DJorange-fo/WireLessCharge/hardwork/SCH_Schematic1_2026-05-12.pdf

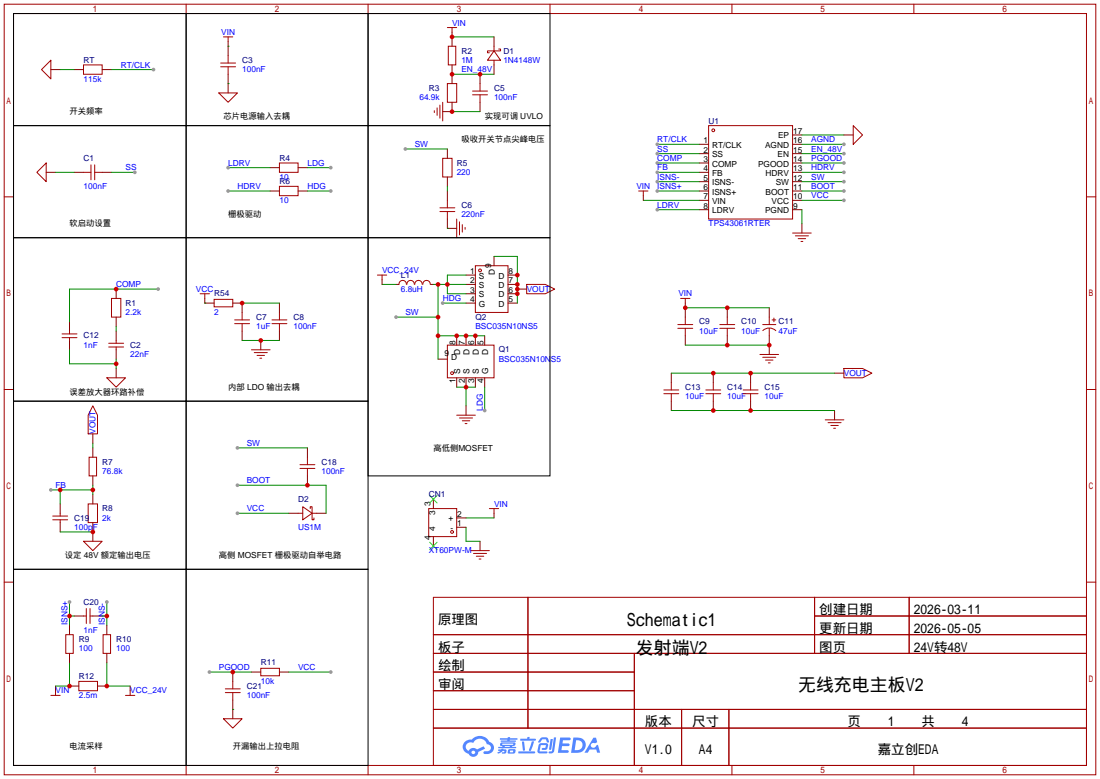
[picture p16: page 1]

VCC 10 BOOT 11 SW 12 HDRV 13 PGOOD 14 EN 15 AGND 16 EP 17

原理图 | Schematic1 | 创建日期 | 2026-03-11

更新日期 | 2026-05-05

板子 | 发射端V2 | 图页 | 24V转48V
绘制 | | 无线充电主板V2
审阅

V1.0 | A4 | 嘉立创EDA

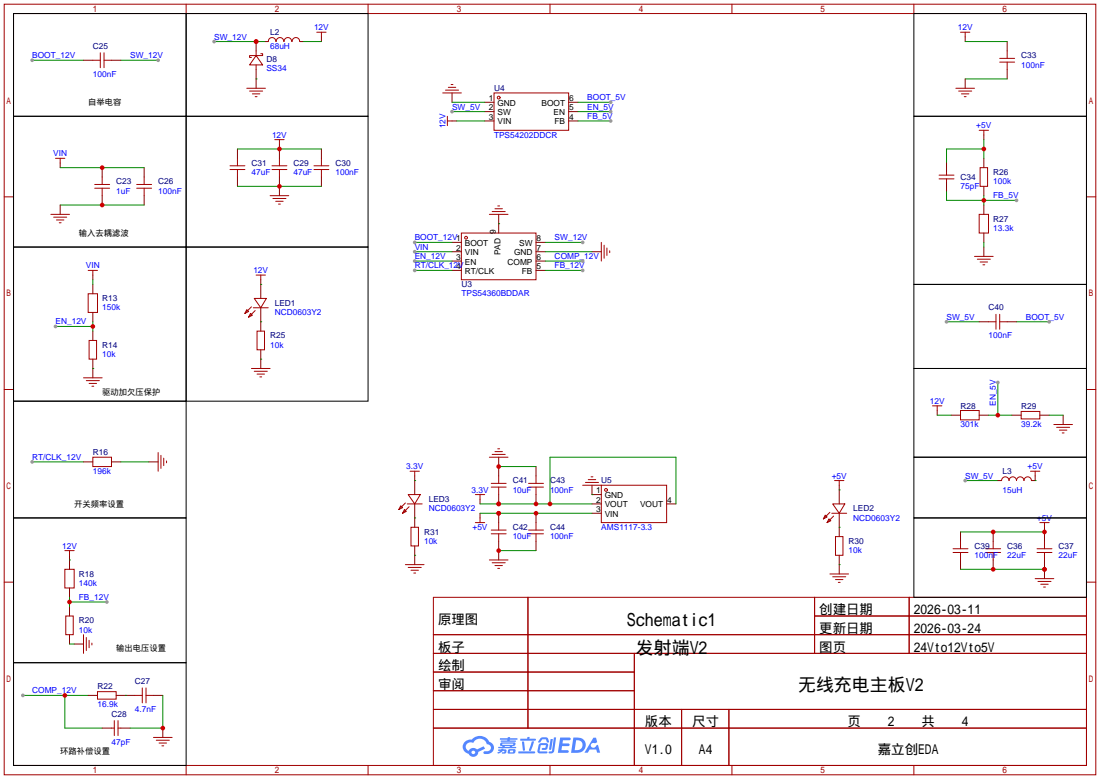
[picture p17: page 2]

原理图 | Schematic1 | 创建日期 | 2026-03-11

更新日期 | 2026-03-24

板子 | 发射端V2 | 图页 | 24Vto12Vto5V
绘制 | | 无线充电主板V2
审阅

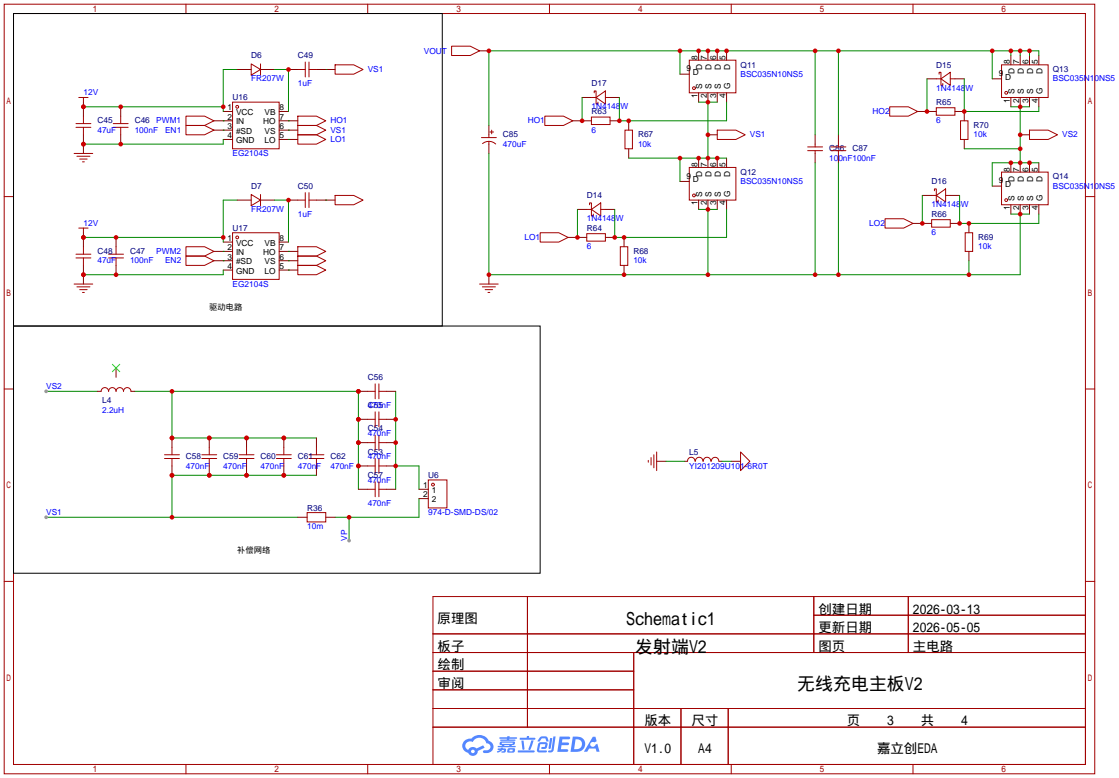
[picture p18: page 3]

原理图 | Schematic1 | 创建日期 | 2026-03-13

更新日期 | 2026-05-05

板子 | 发射端V2 | 图页 | 主电路
绘制 | | 无线充电主板V2
审阅

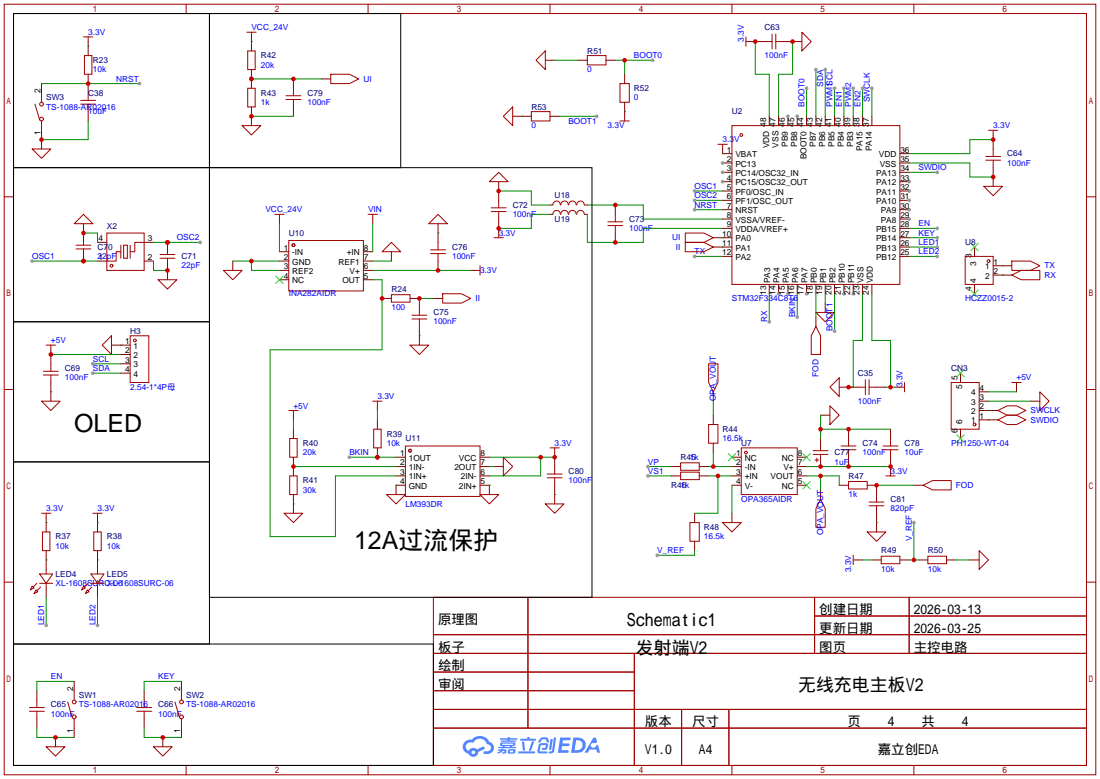
[picture p19: page 4]

原理图 | Schematic1 | 创建日期 | 2026-03-13

更新日期 | 2026-03-25

板子 | 发射端V2 | 图页 | 主控电路
绘制 | | 无线充电主板V2
审阅
