DJorange-fo/WireLessCharge/code/wpt_v2/Core/Src/main.c

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
/* Includes ------------------------------------------------------------------*/
#include "main.h"
#include "adc.h"
#include "dma.h"
#include "tim.h"
#include "gpio.h"

/* USER CODE BEGIN Includes */
#include "fz_hbridge.h"
#include "adc_sensor.h"

#ifdef USE_FREERTOS
#include "FreeRTOS.h"
#include "task.h"

/* External task functions (defined in app_tasks.c) */
extern void vTaskController(void *pvParameters);
extern void vTaskPeripheral(void *pvParameters);

/* System configuration helpers (defined in syscfg.c) */
extern void syscfg_jtag_release(void);
extern void syscfg_powerup_safety(void);
#endif

/* USER CODE END Includes */


void SystemClock_Config(void);
/**
  * @brief  The application entry point.
  * @retval int
  */
int main(void)
{

  /* MCU Configuration--------------------------------------------------------*/

  /* Reset of all peripherals, Initializes the Flash interface and the Systick. */
  HAL_Init();

  /* Configure the system clock */
  SystemClock_Config();

  /* USER CODE BEGIN SysInit */
    /* JTAG release + power-up safety.
     * syscfg_jtag_release() MUST run before MX_GPIO_Init(),
     * otherwise PB3/PB4/PA15 stay locked in JTAG mode. */
    syscfg_jtag_release();
    syscfg_powerup_safety();
  /* USER CODE END SysInit */

  /* Initialize all configured peripherals */
  MX_GPIO_Init();
  MX_DMA_Init();
  MX_TIM2_Init();
  MX_TIM3_Init();
  MX_ADC1_Init();
  /* USER CODE BEGIN 2 */
  fz_hbridge_init();
  fz_hbridge_set_phase(180);

  /* Start ADC1 + DMA circular scan (adc_raw[3] updated continuously) */
  adc_sensor_start();

  #ifdef USE_FREERTOS
  /* FreeRTOS kernel interrupts must be lowest priority on Cortex-M4. */
  HAL_NVIC_SetPriority(SysTick_IRQn,   configLIBRARY_LOWEST_INTERRUPT_PRIORITY, 0);
  HAL_NVIC_SetPriority(PendSV_IRQn,    configLIBRARY_LOWEST_INTERRUPT_PRIORITY, 0);

  {
      extern void vTaskController(void *pv);
      extern void vTaskPeripheral(void *pv);

      xTaskCreate(vTaskController, "ctrl", 200, NULL, 3, NULL);
      xTaskCreate(vTaskPeripheral, "peri", 200, NULL, 1, NULL);
  }

  vTaskStartScheduler();
  #endif
  /* USER CODE END 2 */

  /* Infinite loop */
  /* USER CODE BEGIN WHILE */
  while (1)
  {
    /* USER CODE END WHILE */

    /* USER CODE BEGIN 3 */
    /* Application logic runs in FreeRTOS tasks (app_tasks.c). */
  }
  /* USER CODE END 3 */
}

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
