DJorange-fo/WireLessCharge/code/wpt_v2/wpt_v2.ioc

Mcu.UserName=STM32F334C8Tx
PA0.GPIO_Label=VIN
PA0.Signal=ADC1_IN1
PA1.GPIO_Label=Idc
PA1.Signal=ADC1_IN2
PA13.Signal=SYS_JTMS-SWDIO
PA14.Signal=SYS_JTCK-SWCLK
PA15.GPIO_Label=EN2
PA15.Signal=GPIO_Output
PB0.GPIO_Label=Iac
PB0.Signal=ADC1_IN11
PB15.GPIO_Label=EN
PB15.Signal=GPIO_Input
PB3.GPIO_Label=PWM2
PB3.Signal=S_TIM2_CH2
PB4.GPIO_Label=EN1
PB4.Signal=GPIO_Output
PB5.GPIO_Label=PWM1
PB5.Signal=S_TIM3_CH2
