DJorange-fo/WireLessCharge/code/wpt_v2/Core/Inc/main.h

#define VIN_Pin GPIO_PIN_0
#define VIN_GPIO_Port GPIOA
#define Idc_Pin GPIO_PIN_1
#define Idc_GPIO_Port GPIOA
#define Iac_Pin GPIO_PIN_0
#define Iac_GPIO_Port GPIOB
#define EN_Pin GPIO_PIN_15
#define EN_GPIO_Port GPIOB
#define EN2_Pin GPIO_PIN_15
#define EN2_GPIO_Port GPIOA
#define PWM2_Pin GPIO_PIN_3
#define PWM2_GPIO_Port GPIOB
#define EN1_Pin GPIO_PIN_4
#define EN1_GPIO_Port GPIOB
#define PWM1_Pin GPIO_PIN_5
#define PWM1_GPIO_Port GPIOB
