DJorange-fo/WireLessCharge/(commit log)

2026-05-12 Initial commit: wireless charge project (STM32F334 + simulation)
2026-05-15 firmware: refactor to FreeRTOS multi-task architecture
    - Split bare-metal superloop into 2 FreeRTOS tasks:
    vTaskController (prio 3, 1ms) — ADC/protect/PID placeholder
    vTaskPeripheral (prio 1, 50ms) — button debounce + H-bridge toggle
    - Extract JTAG release + power-up safety into syscfg.c module
    - Add FreeRTOSConfig.h for STM32F334C8T6 (72MHz, 12KB SRAM)
    configTOTAL_HEAP_SIZE=4KB, configUSE_TIMERS=0
    - Adapt stm32f3xx_it.c for FreeRTOS:
    SysTick shared between HAL_IncTick + xPortSysTickHandler
    SVC_Handler/PendSV_Handler macros to avoid CubeMX linker conflict
    - Update Keil project: FreeRTOS kernel sources, include paths, USE_FREERTOS
    - Enable HAL ADC + UART modules in stm32f3xx_hal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
    [app_tasks.c, fz_hbridge.c, fz_hbridge.h, main.c, syscfg.c]
2026-05-15 docs: add FreeRTOS integration skill to CLAUDE.md
    Document all pitfalls and patterns from the bare-metal→FreeRTOS refactor:
    - CubeMX compatibility rules (USER CODE blocks)
    - SVC_Handler/PendSV_Handler conflict resolution (double-macro technique)
    - SysTick sharing between HAL and FreeRTOS
    - configASSERT deadlock trap during bring-up
    - configMAX_SYSCALL_INTERRUPT_PRIORITY hardcoded for ARMCC5 __asm
    - STM32F3 HAL v1.11.6 USE_RTOS limitation
    - Memory budget for 12KB SRAM
    - Keil project FreeRTOS file paths
2026-05-15 firmware: add ADC1 DMA-driven 3-channel sampling module
    - CubeMX: enable ADC1 (PA0/VIN, PA1/Idc, PB0/Iac) + DMA1_Channel1 Circular
    - New module adc_sensor.c/h: physical conversion API with ADC calibration
    - VIN: 20K:1K divider, 1/21 ratio
    - Idc: INA282, 0.125V/A, REF=GND
    - Iac: OPA365, 0.165V/A, REF=1.65V
    - vTaskController now reads fresh ADC data at 1kHz from DMA ring buffer
    - Generated files: adc.c/h, dma.c/h from CubeMX
    - HAL modules enabled: ADC, DMA
